AbdullahBarghouti/ece411/README.md

# ECE411

Practicum project for ECE 411

# Credits

Travis Hermant

Josh Davis

Abdullah Barghouti

Ammar Khan
