AbdullahBarghouti/ece411/Documents/ECE411 Decision Matrix - Sheet1.pdf

Project Ideas
| WT | Plant Monitor | Line Following Car | Light following solar panel | Pan and tilt camera mount
Cost | 4 | 3 | 2 | 1 | 4
Hardware Difficulty | 4 | 3 | 3 | 1 | 3
Software Difficulty | 3 | 2 | 3 | 3 | 4
Retail price | 2 | 2 | 1 | 2 | 4
Usability | 4 | 4 | 1 | 3 | 4
Time to make | 5 | 3 | 3 | 2 | 3
Score | | 65 | 50 | 43 | 79

Group 14
ECE411
