AbdullahBarghouti/ece411/EagleCAD/PCB Design/ECE411_Project1.png

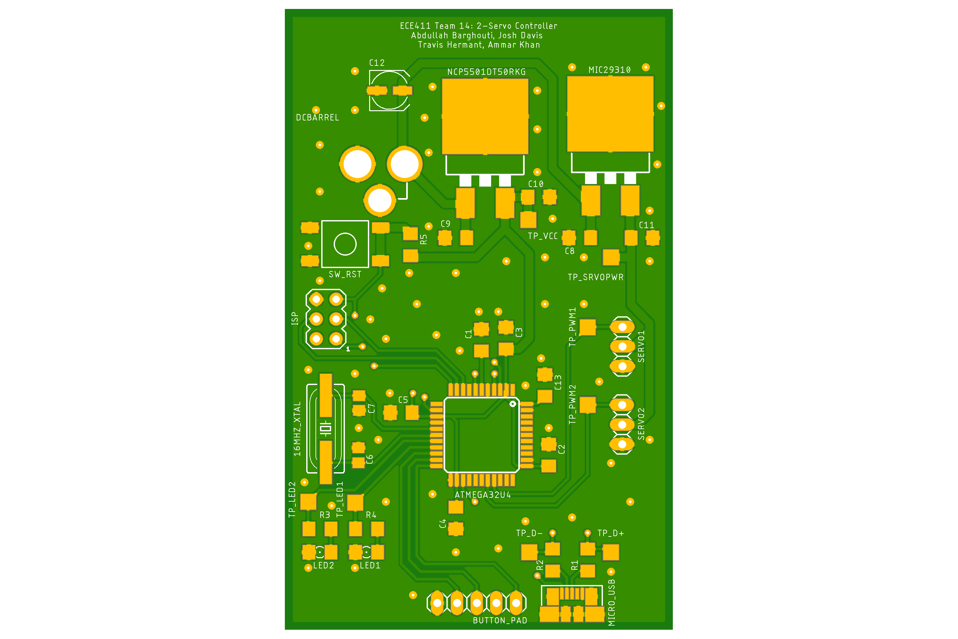
EagleCAD/PCB Design/ECE411_Project1.png
