AbdullahBarghouti/ece411/Documents/Arrow BOM ECE411 Practicum Project.xlsx

Arrow Electronics, Inc.
BOM Name: | ECE411 Practicum Project
Downloaded: | Thu Nov 15 2018 07:45:12 GMT+0000 (Coordinated Universal Time)
Part Details |  |  |  |  |  |  | Purchasing Options |  |  |  |  |  |  |  |  |  |  |  | Extra Part Details
Part Number | Manufacturer | Requested Qty | Quoted | Total Stock | Total Price | Description | Packaging | Allocated | Stock | Availability | Price per Part | Option Total | MOQ | Increment | Ships | Source | Location | Lead Time | Rohs | Lifecycle | Note | Details | Reference Designator(s)
CL31A106MOHNNNE | Samsung Electro-Mechanics | 10 | 10 | 12056 | 1.832 | Cap Ceramic 10uF 16V X5R 20% Pad SMD 1206 85°C T/R | Cut Strip | 10 | 12056 | In Stock | 0.2544 | 2.544 | 1 | 1 | Immediately | Arrow | USA | 30 Week(s) | Yes | Active |  | https://www.arrow.com/products/cl31a106mohnnne/samsung-electro-mechanics
C1206X105K5RECAUTO | KEMET Corporation | 6 | 6 | 764 | 3.135 | Cap Ceramic 1uF 50V X7R 10% Pad SMD 1206 Flexible Termination 125°C Automotive T/R | Cut Strip | 6 | 764 | In Stock | 0.5225 | 3.135 | 1 | 1 | Immediately | Arrow | USA | 47 Week(s) | Yes |  |  | https://www.arrow.com/products/c1206x105k5recauto/kemet-corporation
AC1206JR-071KL | Yageo | 10 | 10 | 1417 | 0.526 | Res Thick Film 1206 1K Ohm 5% 0.25W(1/4W) ±100ppm/°C Epoxy Pad SMD Automotive T/R | Cut Strip | 10 | 1417 | In Stock | 0.095 | 0.95 | 1 | 1 | Immediately | Arrow | USA | 7 Week(s) | No | Active |  | https://www.arrow.com/products/ac1206jr-071kl/yageo
CL31A475KOHNNNE | Samsung Electro-Mechanics | 6 | 6 | 20 | 1.995 | Cap Ceramic 4.7uF 16V X5R 10% Pad SMD 1206 85°C T/R | Cut Strip | 6 | 20 | In Stock | 0.3325 | 1.995 | 1 | 1 | Immediately | Arrow | USA | 30 Week(s) | Yes | Active |  | https://www.arrow.com/products/cl31a475kohnnne/samsung-electro-mechanics
47346-0001 | Molex | 5 | 5 | 14223 | 2.99 | Conn Micro USB 2.0 Type B RCP 5 POS 0.65mm Solder RA SMD 5 Terminal 1 Port T/R | Supplier | 5 | 14223 | In Stock | 0.598 | 2.99 | 5 | 1 | 11 Day(s) | Arrow | USA | 0 Week(s) | Yes | Active |  | https://www.arrow.com/products/47346-0001/molex
C1206C104K5JACTU | KEMET Corporation | 28 | 28 | 841 | 10.2116 | Cap Ceramic 0.1uF 50V U2J 10% Pad SMD 1206 125°C T/R | Cut Strip | 28 | 841 | In Stock | 0.437 | 12.236 | 1 | 1 | Immediately | Arrow | USA | 99 Week(s) | Yes |  |  | https://www.arrow.com/products/c1206c104k5jactu/kemet-corporation
NCP5501DT50RKG | ON Semiconductor | 5 | 5 | 3928 | 3.01 | LDO Regulator Pos 5V 0.5A 3-Pin(2+Tab) DPAK T/R | Cut Strip | 5 | 3928 | In Stock | 0.602 | 3.01 | 1 | 1 | Immediately | Arrow | USA | 9 Week(s) | No | Active |  | https://www.arrow.com/products/ncp5501dt50rkg/on-semiconductor
3642 | Adafruit Industries | 5 | 5 | 197 | 10.745 | Conn 2.1mm DC Barrel RCP Solder RA Thru-Hole 3 Terminal 1 Port | Supplier | 5 | 197 | In Stock | 2.149 | 10.745 | 1 | 1 | Immediately | Arrow | USA | 99 Week(s) | Yes | Active |  | https://www.arrow.com/products/3642/adafruit-industries
UWT1V100MCL1GB | Nichicon | 6 | 6 | 106014 | 1.653 | Cap Aluminum Lytic 10uF 35V 20% (5 X 5.4mm) SMD 25mA 1000h 105°C T/R | Supplier | 0 | 105000 | In Stock | 0 | 0 | 1000 | 1000 | 4 Day(s) | Arrow | NL | 20 Week(s) | Yes | Active |  | https://www.arrow.com/products/uwt1v100mcl1gb/nichicon
 |  |  |  |  |  |  | Reel | 0 | 1000 | In Stock | 0 | 0 | 1000 | 1000 | Immediately | Arrow | USA | 17 Week(s)
 |  |  |  |  |  |  | Cut Strip | 6 | 14 | In Stock | 0.2755 | 1.653 | 1 | 1 | Immediately | Arrow | USA | 17 Week(s)
QBLP650-AG | QT-Brightek Corporation | 12 | 12 | 8998 | 3.1584 | TOP MOUNT BRIGHT 1206 LEDS | Cut Strip | 12 | 8998 | In Stock | 0.36 | 4.32 | 1 | 1 | Immediately | Arrow | USA | 8 Week(s) | Yes | Active |  | https://www.arrow.com/products/qblp650-ag/qt-brightek-corporation
SG73G2BTTD1002D | KOA Speer Electronics | 6 | 6 | 4665 | 1.311 | Res Thick Film 1206 10K Ohm 0.5% 0.5W(1/2W) ±50ppm/°C Pad SMD Automotive T/R | Cut Strip | 6 | 4665 | In Stock | 0.2185 | 1.311 | 1 | 1 | Immediately | Arrow | USA | 10 Week(s) | No | Active |  | https://www.arrow.com/products/sg73g2bttd1002d/koa-speer-electronics
SG73G2BTTD22R0D | KOA Speer Electronics | 10 | 10 | 4971 | 2.163 | Res Thick Film 1206 22 Ohm 0.5% 0.5W(1/2W) ±50ppm/°C Pad SMD Automotive T/R | Cut Strip | 10 | 4971 | In Stock | 0.2185 | 2.185 | 1 | 1 | Immediately | Arrow | USA | 10 Week(s) | No | Active |  | https://www.arrow.com/products/sg73g2bttd22r0d/koa-speer-electronics
MIC29310-5.0WU | Microchip Technology | 5 | 5 | 798 | 10.905 | LDO Regulator Pos 5V 3A 4-Pin(3+Tab) TO-263 Tube | Supplier | 5 | 798 | In Stock | 2.181 | 10.905 | 1 | 1 | Immediately | Arrow | USA | 7 Week(s) | No | Active |  | https://www.arrow.com/products/mic29310-5.0wu/microchip-technology
ATS160SM-1 | CTS | 4 | 4 | 4 | 1.2712 | Crystal 16MHz ±30ppm (Tol) ±50ppm (Stability) Series FUND 40Ohm 2-Pin HC-49/US SM SMD T/R | Cut Strip | 4 | 4 | In Stock | 0.3178 | 1.2712 | 1 | 1 | Immediately | Arrow | USA | 9 Week(s) | Yes | Active |  | https://www.arrow.com/products/ats160sm-1/cts
08052A220JAT2A | AVX | 12 | 12 | 7750 | 2.166 | Cap Ceramic 22pF 200V C0G 5% Pad SMD 0805 125°C T/R | Cut Strip | 12 | 7750 | In Stock | 0.266 | 3.192 | 1 | 1 | Immediately | Arrow | USA | 30 Week(s) | Yes | Active |  | https://www.arrow.com/products/08052a220jat2a/avx
FSM2JSMLTR | TE Connectivity | 5 | 5 | 12000 | 2.8415 | Switch Tactile OFF (ON) SPST Round Button Gull Wing 0.05A 24VDC 0.98N SMD T/R | Reel | 0 | 10800 | In Stock | 0 | 0 | 1200 | 1200 | Immediately | Arrow | USA | 11 Week(s) | Yes | Active |  | https://www.arrow.com/products/fsm2jsmltr/te-connectivity
 |  |  |  |  |  |  | Cut Strip | 5 | 1200 | In Stock | 0.5683 | 2.8415 | 1 | 1 | Immediately | Arrow | USA | 11 Week(s)
150-1-002-0-S-XS0-0835 | MPE-Garry GmbH | 10 | 10 | 29 | 0.752 | Pin Header 2,00 mm Series 150 | Supplier | 10 | 29 | In Stock | 0.0846 | 0.846 | 1 | 1 | 4 Day(s) | Arrow | NL | 10 Week(s) | Yes | Active |  | https://www.arrow.com/products/150-1-002-0-s-xs0-0835/mpe-garry-gmbh
HPH2-A-06-UA | ADAM TECH | 6 | 6 | 100 | 3.81 | Pin Header 6P 1.27mm Pitch | Supplier | 6 | 100 | In Stock | 0.635 | 3.81 | 1 | 1 | Immediately | Arrow | USA | 0 Week(s) | Yes | Active |  | https://www.arrow.com/products/hph2-a-06-ua/adam-tech
