AbdullahBarghouti/ece411/Documents/ECE_411_Bill_of_Materials.xlsx

Table 1
Count | Part | Value | Device | Package | Description | SPICEPREFIX | Vendor | MFG | Cost Each ($) | Cost ext. ($) | Link
2 | BUTTON_PAD, SERVO1, SERVO2 |  | PINHD-1X10 | 1X10 | PIN HEADER |  | Arrow | MPE-Garry GmbH | 0.08 | 0.16 | https://www.arrow.com/en/products/150-1-002-0-s-xs0-0835/mpe-garry-gmbh
1 | C1 | 1u | C1206X105K5RECAUTO | C1206 | Ceramic Capacitor | C | Arrow | KEMET Corp | 0.52 | 0.52 | https://www.arrow.com/en/products/c1206x105k5recauto/kemet-corporation
6 | C2, C3, C4, C5, C8, C13 | 0.1u | C1206C104K5JACTU | C1206 | Ceramic Capacitor | C | Arrow | KEMET Corp | 0.44 | 2.64 | https://www.arrow.com/en/products/c1206c104k5jactu/kemet-corporation
2 | C6, C7 | 22p | 08052A220JAT2A | C0805 | Ceramic Capacitor | C | Arrow | AVX | 0.27 | 0.54 | https://www.arrow.com/en/products/08052a220jat2a/avx
2 | C9, C11 | 10u | CL31A106MOHNNNE | C1206 | Ceramic Capacitor | C | Arrow | Samsung Electro-Mechanics | 0.25 | 0.5 | https://www.arrow.com/en/products/cl31a106mohnnne/samsung-electro-mechanics
1 | C12 | 10u | UWT1V100MCL1GB | UD-5X5, 4_NICHICON | Dielectric (Polarized) Capacitor | C | Arrow | Nichicon | 0.04 | 0.04 | https://www.arrow.com/en/products/uwt1v100mcl1gb/nichicon
1 | C10 | 4.7u | CL31A475KOHNNNE | C1206 | Ceramic Capacitor | C | Arrow | Samsung Electro-Mechanics | 0.33 | 0.33 | https://www.arrow.com/en/products/cl31a475kohnnne/samsung-electro-mechanics
1 | ISP1 |  | AVRISP-6 | AVRISP | AVR ISP HEADER |  | Arrow | Adam Tech | 0.635 | 0.635 | https://www.arrow.com/en/products/hph2-a-06-ua/adam-tech
1 | MICRO_USB |  | 047346-0001 | MOLEX_USBMICRO | USB Micro Connector Type B |  | Arrow | Molex | 0.598 | 0.598 | https://www.arrow.com/en/products/47346-0001/molex
2 | LED1, LED2 |  | QBLP650-AG | 1206 | LED |  | Arrow | QT-Brightek | 0.36 | 0.72 | https://www.arrow.com/en/products/qblp650-ag/qt-brightek-corporation
2 | R1, R2 | 22 | SG73G2BTTD22R0D | R1206 | RESISTOR | R | Arrow | KOA Speer Electronics | 0.22 | 0.44 | https://www.arrow.com/en/products/sg73g2bttd22r0d/koa-speer-electronics
2 | R3, R4 | 1k | AC1206JR-071KL | R1206 | RESISTOR | R | Arrow | Yageo | 0.1 | 0.2 | https://www.arrow.com/en/products/ac1206jr-071kl/yageo
1 | R5 | 10k | SG73G2BTTD1002D | R1206 | RESISTOR | R | Arrow | KOA Speer Electronics | 0.22 | 0.22 | https://www.arrow.com/en/products/sg73g2bttd1002d/koa-speer-electronics
2 | SERVO1, SERVO2 |  | SG90 9G Nylon-Gear | SG90 | Servo Motor |  | Amazon |  | 1.8 | 3.6
1 | SW_RST |  | FSM2JSMLTR | FSM2JSMLTR | Push Button SPST Switch N.O. |  | Arrow | TE Connectivity | 0.57 | 0.57 | https://www.arrow.com/en/products/fsm2jsmltr/te-connectivity
1 | U$1 |  | ATMEGA32U4-AU | TQFP44 | Microcontroller |  | Arrow |  | 3.955 | 3.955
1 | XTAL1 | 16MHz | ATS160SM-1 | ATS160SM-1 | Crystal Oscillator |  | Arrow | CTS | 0.32 | 0.32 | https://www.arrow.com/en/products/ats160sm-1/cts
1 | U2 | MIC29310-5.0WU | MIC29310-5.0WU | TO-263/D2PAK | 5V 3A Linear Voltage Regulator |  | Arrow | Microchip | 2.18 | 2.18 | https://www.arrow.com/en/products/mic29310-5.0wu/microchip-technology
1 | U3 | NCP5501DT50RKG | NCP5501DT50RKG | TO-263/D2PAK | 5V 0.5A Linear Voltage Regulator |  | Arrow | ON Semiconductor | 0.6 | 0.6 | https://www.arrow.com/en/products/ncp5501dt50rkg/on-semiconductor
1 | U4 | DCJACK_2.1MM_PTH | 3462 | DCJACK_2.1MM_PTH | DC Barrel Jack (Thru-Hole) |  | Arrow | Adafruit | 2.15 | 2.15 | https://www.arrow.com/en/products/3642/adafruit-industries
 |  |  |  |  |  |  |  |  | Total $: | 20.92
