AbdullahBarghouti/ece411/EagleCAD/PCBSchematicImage.pdf

A

A

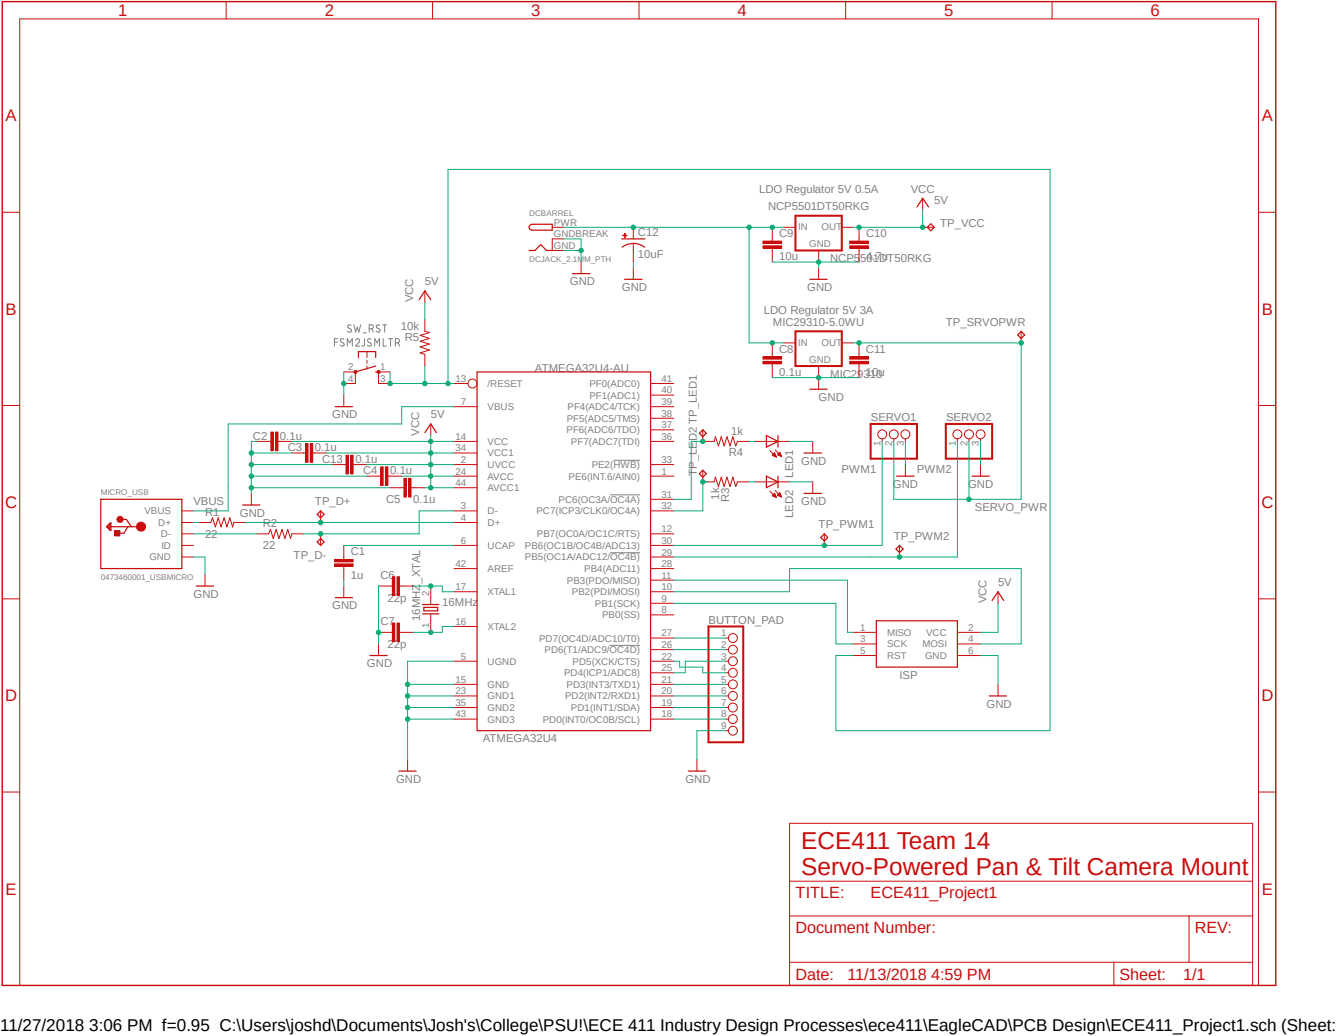
[picture p3: page 1]

0.1u
C13

ECE411 Team 14
Servo-Powered Pan & Tilt Camera Mount
TITLE:

Document Number: | REV:

Date: 11/13/2018 4:59 PM | Sheet: 1/1

11/27/2018 3:06 PM f=0.95 C:\Users\joshd\Documents\Josh's\College\PSU!\ECE 411 Industry Design Processes\ece411\EagleCAD\PCB Design\ECE411_Project1.sch (Sheet: 1/1)
