AbdullahBarghouti/ece411/EagleCAD/PCBLayoutImage.pdf

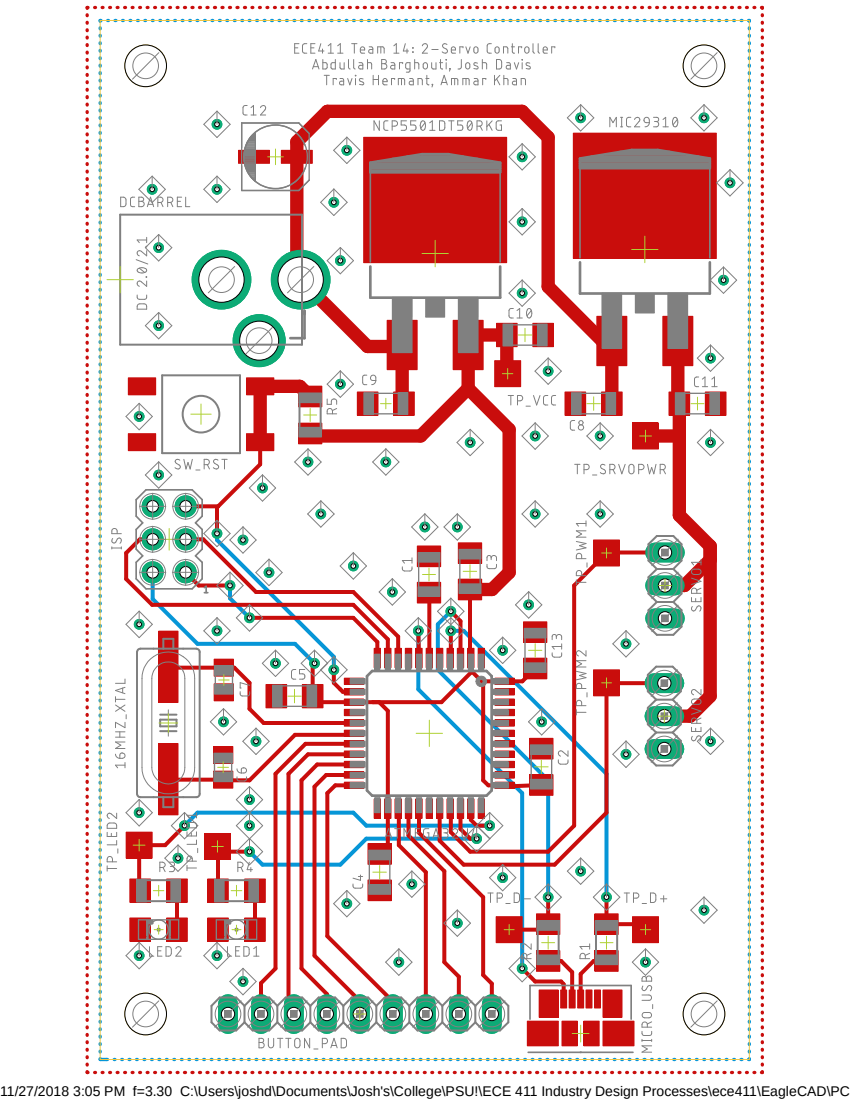
[picture p4: page 1]

11/27/2018 3:05 PM f=3.30 C:\Users\joshd\Documents\Josh's\College\PSU!\ECE 411 Industry Design Processes\ece411\EagleCAD\PCB Design\ECE411_Project1.brd
