AbdullahBarghouti/ece411/EagleCAD/PCB Design/ECE411_Project1.brd

## EAGLE design EagleCAD/PCB Design/ECE411_Project1.brd (2018-11-15)

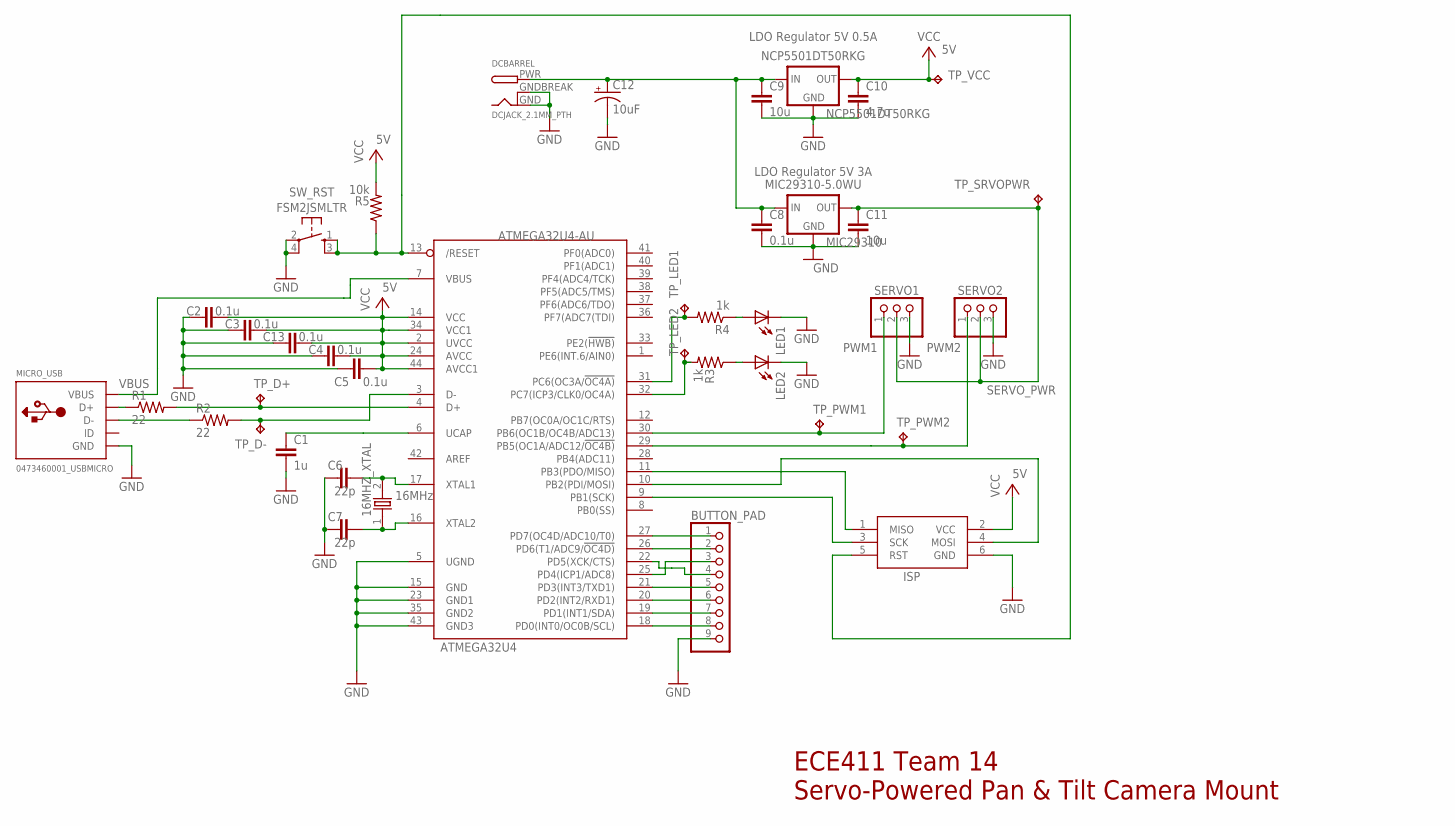
[picture p5: schematic ECE411_Project1.sch]

Parts:
16MHZ_XTAL: 16MHz; ATS160SM-1
ATMEGA32U4: ATMEGA32U4-AU; TQFP44
BUTTON_PAD: PINHD-1X9; 1X09
C1: 1u; C1206
C2, C3, C4, C5, C8, C13: 0.1u; C1206
C6, C7: 22p; C0805
C9, C11: 10u; C1206
C10: 4.7u; C1206
C12: 10uF; UD-5X5,4_NICHICON
DCBARREL: DCJACK_2.1MM_PTH
ISP: AVRISP-6; AVRISP
LED1, LED2: LEDSMT1206; 1206
MIC29310: MIC29310-5.0WU; TO-263/D2PAK
MICRO_USB: 0473460001_USBMICRO; MOLEX_USBMICRO
NCP5501DT50RKG: NCP5501DT50RKG; TO-263/D2PAK
R1, R2: 22; R1206
R3, R4: 1k; R1206
R5: 10k; R1206
SERVO1, SERVO2: PINHD-1X3; 1X03
SW_RST: FSM2JSMLTR
TP_D+: TPTP20SQ; TP20SQ
TP_D-: TPTP20SQ; TP20SQ
TP_LED1, TP_LED2: TPTP20SQ; TP20SQ
TP_PWM1, TP_PWM2: TPTP20SQ; TP20SQ
TP_SRVOPWR: TPTP20SQ; TP20SQ
TP_VCC: TPTP20SQ; TP20SQ

Connections:
/RST: ATMEGA32U4.13 (/RESET), ISP.5 (RST), R5.1, SW_RST.1, SW_RST.3
CHIP_LED1: ATMEGA32U4.31 (PC6(OC3A/!OC4A)), R4.2, TP_LED1.TP
CHIP_LED2: ATMEGA32U4.32 (PC7(ICP3/CLK0/OC4A)), R3.2, TP_LED2.TP
D+MCU: ATMEGA32U4.4 (D+), R1.2, TP_D+.TP
D+USB: MICRO_USB.3 (D+), R1.1
D-MCU: ATMEGA32U4.3 (D-), R2.2, TP_D-.TP
D-USB: MICRO_USB.2 (D-), R2.1
GND: ATMEGA32U4.5 (UGND), ATMEGA32U4.15 (GND), ATMEGA32U4.23 (GND1), ATMEGA32U4.35 (GND2), ATMEGA32U4.43 (GND3), BUTTON_PAD.9, C1.2, C2.1, C3.1, C4.1, C5.1, C6.1, C7.1, C8.2, C9.2, C10.2, C11.2, C12.-, C13.1, DCBARREL.GND, DCBARREL.GNDBREAK, ISP.6 (GND), LED1.C, LED2.C, MIC29310.2 (GND), MICRO_USB.5 (GND), MICRO_USB.G1 (GND), MICRO_USB.G2 (GND), MICRO_USB.G3 (GND), MICRO_USB.G4 (GND), MICRO_USB.G5 (GND), MICRO_USB.G6 (GND), NCP5501DT50RKG.2 (GND), SERVO1.3, SERVO2.3, SW_RST.2, SW_RST.4
unnamed: ATMEGA32U4.27 (PD7(OC4D/ADC10/T0)), BUTTON_PAD.1
unnamed: ATMEGA32U4.26 (PD6(T1/ADC9/!OC4D)), BUTTON_PAD.2
unnamed: ATMEGA32U4.25 (PD4(ICP1/ADC8)), BUTTON_PAD.3
unnamed: ATMEGA32U4.22 (PD5(XCK/CTS)), BUTTON_PAD.4
unnamed: ATMEGA32U4.21 (PD3(INT3/TXD1)), BUTTON_PAD.5
unnamed: ATMEGA32U4.20 (PD2(INT2/RXD1)), BUTTON_PAD.6
unnamed: LED2.A, R3.1
unnamed: LED1.A, R4.1
unnamed: ATMEGA32U4.19 (PD1(INT1/SDA)), BUTTON_PAD.7
unnamed: ATMEGA32U4.18 (PD0(INT0/OC0B/SCL)), BUTTON_PAD.8
unnamed: ATMEGA32U4.11 (PB3(PDO/MISO)), ISP.1 (MISO)
unnamed: ATMEGA32U4.10 (PB2(PDI/MOSI)), ISP.4 (MOSI)
unnamed: ATMEGA32U4.9 (PB1(SCK)), ISP.3 (SCK)
PWM1: ATMEGA32U4.30 (PB6(OC1B/OC4B/ADC13)), SERVO1.1, TP_PWM1.TP
PWM2: ATMEGA32U4.29 (PB5(OC1A/ADC12/!OC4B)), SERVO2.1, TP_PWM2.TP
SERVO_PWR: C11.1, MIC29310.3 (OUT), SERVO1.2, SERVO2.2, TP_SRVOPWR.TP
UCAP: ATMEGA32U4.6 (UCAP), C1.1
UNREG_PWR: C8.1, C9.1, C12.+, DCBARREL.PWR, MIC29310.1 (IN), NCP5501DT50RKG.1 (IN)
VBUS: ATMEGA32U4.7 (VBUS), MICRO_USB.1 (VBUS)
VCC: ATMEGA32U4.2 (UVCC), ATMEGA32U4.14 (VCC), ATMEGA32U4.24 (AVCC), ATMEGA32U4.34 (VCC1), ATMEGA32U4.44 (AVCC1), C2.2, C3.2, C4.2, C5.2, C10.1, C13.2, ISP.2 (VCC), NCP5501DT50RKG.3 (OUT), R5.2, TP_VCC.TP
XTAL1: 16MHZ_XTAL.2, ATMEGA32U4.17 (XTAL1), C6.2
XTAL2: 16MHZ_XTAL.1, ATMEGA32U4.16 (XTAL2), C7.2

Notes on the sheet:
LDO Regulator 5V 0.5A
LDO Regulator 5V 3A
ECE411 Team 14 Servo-Powered Pan & Tilt Camera Mount

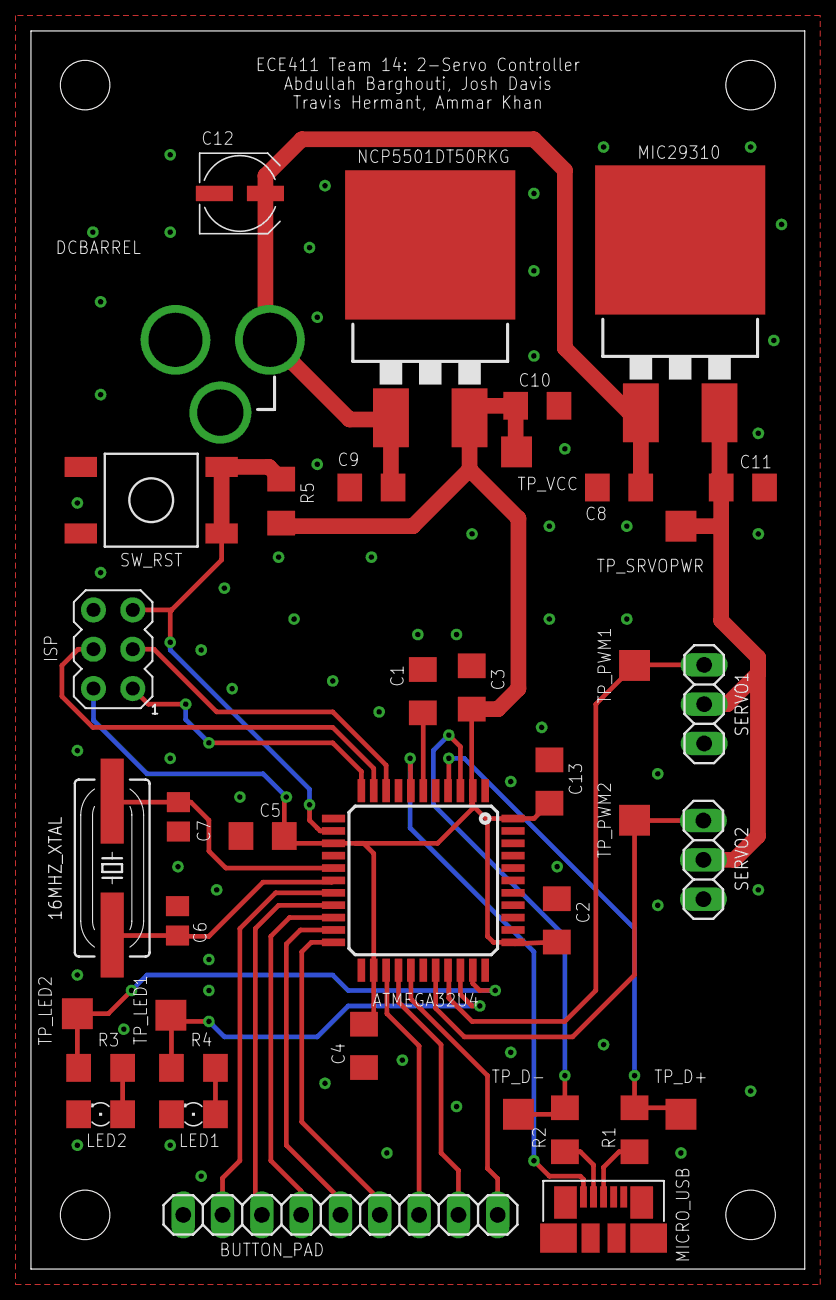
[picture p6: board ECE411_Project1.brd from above]

Board: 2 copper layers, 50.0 x 80.0 mm, 39 parts (0 on the bottom side), 30 nets.
