AbdullahBarghouti/ece411/EagleCAD/Adafruit-ItsyBitsy-32u4-PCB-master/Itsy Bitsy 32u4 5V.brd

## EAGLE design EagleCAD/Adafruit-ItsyBitsy-32u4-PCB-master/Itsy Bitsy 32u4 5V.brd (2018-10-24)

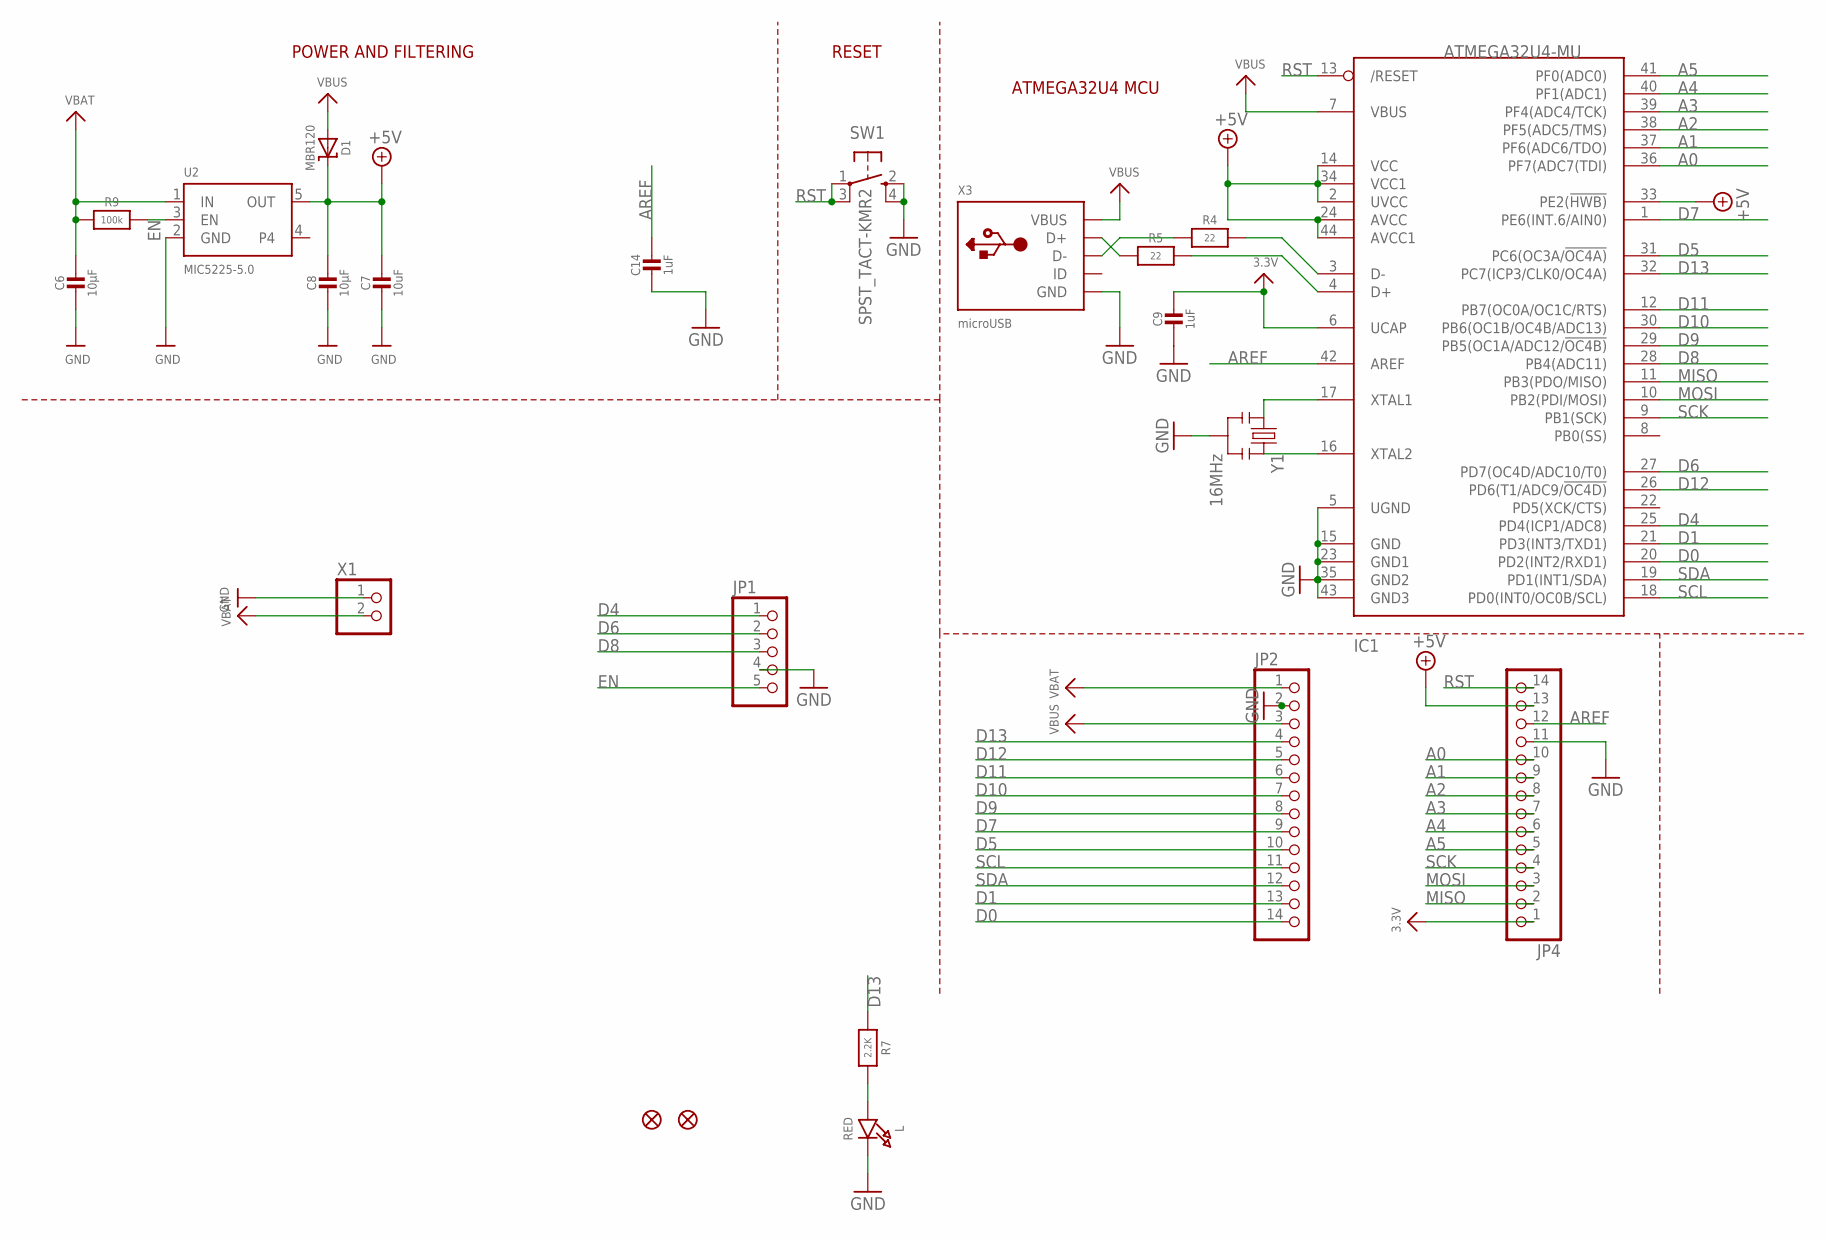
[picture p7: schematic Itsy Bitsy 32u4 5V.sch]

Parts:
C6, C8: 10µF; 0805-NO
C7: 10uF; 0805-NO
C9, C14: 1uF; 0603-NO
D1: MBR120; SOD-123
IC1: ATMEGA32U4-MU; TQFN44_7MM
JP1: HEADER-1X5ROUND; 1X05_ROUND
JP2, JP4: HEADER-1X14; 1X14_ROUND70
L: RED; CHIPLED_0805_NOOUTLINE
R4, R5: 22; 0603-NO
R7: 2.2K; 0603-NO
R9: 100k; 0603-NO
SW1: SPST_TACT-KMR2; KMR2
U2: MIC5225-5.0; SOT23-5
U$34, U$35: FIDUCIAL""; FIDUCIAL_1MM
X1: CON_JST_PH_2PIN; JSTPH2
X3: microUSB; 4UCONN_20329_V2
Y1: 16MHz; RESONATOR-SMD

Connections:
3.3V: C9.1, IC1.6 (UCAP), JP4.1
+5V: C7.1, C8.1, D1.C, IC1.2 (UVCC), IC1.14 (VCC), IC1.24 (AVCC), IC1.33 (PE2(!HWB)), IC1.34 (VCC1), IC1.44 (AVCC1), JP4.13, U2.5 (OUT)
A0: IC1.36 (PF7(ADC7(TDI)), JP4.10
A1: IC1.37 (PF6(ADC6/TDO)), JP4.9
A2: IC1.38 (PF5(ADC5/TMS)), JP4.8
A3: IC1.39 (PF4(ADC4/TCK)), JP4.7
A4: IC1.40 (PF1(ADC1)), JP4.6
A5: IC1.41 (PF0(ADC0)), JP4.5
AREF: C14.1, IC1.42 (AREF), JP4.12
D0: IC1.20 (PD2(INT2/RXD1)), JP2.14
D1: IC1.21 (PD3(INT3/TXD1)), JP2.13
D4: IC1.25 (PD4(ICP1/ADC8)), JP1.1
D5: IC1.31 (PC6(OC3A/!OC4A)), JP2.10
D6: IC1.27 (PD7(OC4D/ADC10/T0)), JP1.2
D7: IC1.1 (PE6(INT.6/AIN0)), JP2.9
D8: IC1.28 (PB4(ADC11)), JP1.3
D9: IC1.29 (PB5(OC1A/ADC12/!OC4B)), JP2.8
D10: IC1.30 (PB6(OC1B/OC4B/ADC13)), JP2.7
D11: IC1.12 (PB7(OC0A/OC1C/RTS)), JP2.6
D12: IC1.26 (PD6(T1/ADC9/!OC4D)), JP2.5
D13: IC1.32 (PC7(ICP3/CLK0/OC4A)), JP2.4, R7.1
D+: IC1.4 (D+), R5.2
D-: IC1.3 (D-), R4.2
EN: JP1.5, R9.2, U2.3 (EN)
GND: C6.2, C7.2, C8.2, C9.2, C14.2, IC1.5 (UGND), IC1.15 (GND), IC1.23 (GND1), IC1.35 (GND2), IC1.43 (GND3), JP1.4, JP2.2, JP4.11, L.C, SW1.2 (S), SW1.4 (S1), U2.2 (GND), X1.1, X3.BASE@1 (GND), X3.BASE@2 (GND), X3.GND, X3.SPRT@1 (GND), X3.SPRT@2 (GND), X3.SPRT@3 (GND), X3.SPRT@4 (GND), Y1.2
MISO: IC1.11 (PB3(PDO/MISO)), JP4.2
MOSI: IC1.10 (PB2(PDI/MOSI)), JP4.3
unnamed: L.A, R7.2
unnamed: IC1.16 (XTAL2), Y1.3
unnamed: IC1.17 (XTAL1), Y1.1
unnamed: R5.1, X3.D+
unnamed: R4.1, X3.D-
RST: IC1.13 (/RESET), JP4.14, SW1.1, SW1.3 (P1)
SCK: IC1.9 (PB1(SCK)), JP4.4
SCL: IC1.18 (PD0(INT0/OC0B/SCL)), JP2.11
SDA: IC1.19 (PD1(INT1/SDA)), JP2.12
VBAT: C6.1, JP2.1, R9.1, U2.1 (IN), X1.2
VBUS: D1.A, IC1.7 (VBUS), JP2.3, X3.VBUS

Notes on the sheet:
POWER AND FILTERING
RESET
ATMEGA32U4 MCU

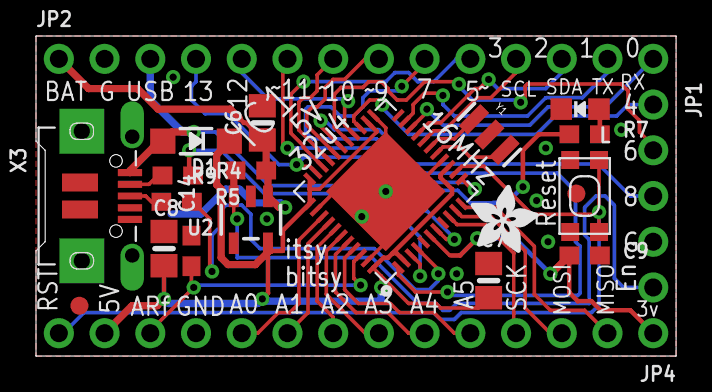
[picture p8: board Itsy Bitsy 32u4 5V.brd from above]

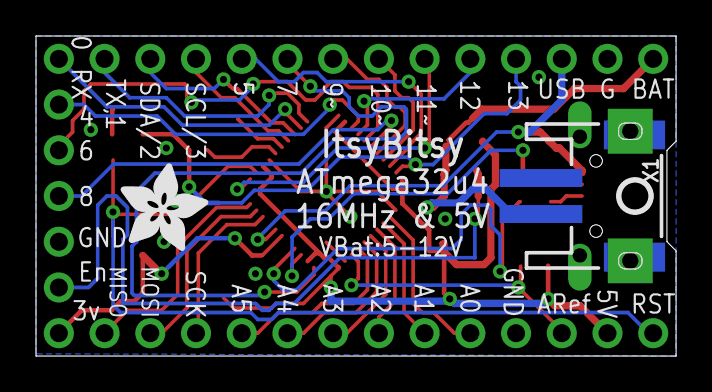
[picture p9: board Itsy Bitsy 32u4 5V.brd from below]

Board: 2 copper layers, 35.6 x 17.8 mm, 25 parts (3 on the bottom side), 38 nets.

Other parts of the board:
U$4: ADAFRUIT_5MM
U$7: ADAFRUIT_3.5MM
U$10: PCBFEAT-REV-040
