AbdullahBarghouti/ece411/(commit log)

2018-10-24 Added Itsy Bitsy EagleCad schematic to the repo
    [Itsy Bitsy 32u4 3V.brd, Itsy Bitsy 32u4 3V.sch, Itsy Bitsy 32u4 5V.brd, Itsy Bitsy 32u4 5V.sch, PCB_Schematic_V1.sch]
2018-10-25 Add files via upload
    Preliminary schematic
    [ECE411_Project1.sch, Project1.sch]
2018-10-25 Create Preliminary schematic
2018-10-25 Added push button for ~Reset pin; named USB port
2018-10-25 removed empty schematic1 EagleCAD file
    [PCB_Schematic_V1.sch]
2018-10-25 Beautified the circuit: rotated and connected the servos directly to the ATMega32U4
    [ECE411_Project1.sch]
2018-10-26 Added ISP 6-pin port to the schematic
    [ECE411_Project1.sch]
2018-11-01 In-Progress schematic: working to add voltage regulators
    [ECE411_Project1.brd, ECE411_Project1.sch]
2018-11-02 Cleaning up
    [ECE411_Project1.brd, ECE411_Project1.sch]
2018-11-03 Added Custom libraries - one for the NE5532 example from the workshop and one for the L7805ABV voltage regulator from the EPL.
2018-11-03 Made Xtal library file
    [ECE411_Project1.brd, ECE411_Project1.sch]
2018-11-03 updates to schematic
    [ECE411_Project1.sch]
2018-11-03 Updating schematic... Updated Links document.
2018-11-04 Added some custom library components, updated schematic with new xtal cap values, and updated links document
    [ECE411_Project1.brd, ECE411_Project1.sch]
2018-11-04 Updating schematic,added push button library file
2018-11-04 Updated Schematic
    [ECE411_Project1.brd, ECE411_Project1.sch]
2018-11-04 Visually complete schematic - nets need to be named still, and erc needs to be run.
    [ECE411_Project1.brd, ECE411_Project1.sch]
2018-11-04 changed xtal caps to 0805 size from 1206
    [ECE411_Project1.brd, ECE411_Project1.sch]
2018-11-04 Updated schematic with new DC barrel component that is thru-hole 2.1MM size
    [ECE411_Project1.brd, ECE411_Project1.sch]
2018-11-04 Started the PCB - Everything's on the board and messy!
    [ECE411_Project1.brd, ECE411_Project1.sch]
2018-11-04 Added test points all over the place
    [ECE411_Project1.brd, ECE411_Project1.sch]
2018-11-05 Add files via upload
    connections made and test passed
    [ECE411_Project1.brd]
2018-11-06 Updated schem and brd files
    [ECE411_Project1_RE.brd, ECE411_Project1_RE.sch]
2018-11-06 Fixed a couple ERC errors... there are a couple left still.
    [ECE411_Project1_RE.sch]
2018-11-07 added electrolytic cap to schematic
2018-11-08 added design review for Team 7
    [BOM file FROM TAI.xlsx, BOM file.xlsx, freq_count_schematic_110718.sch, freq_count_schematic_updated_11_6_2018.brd]
2018-11-08 Restarted the PCB layout process, and created new schematic and layout files to use. The new file names removed the _RE at the end, they're titled ECE411_Project1
    [ECE411_Project1.brd, ECE411_Project1.sch]
2018-11-08 updated in-progress PCB layout
2018-11-08 in-progress updates: Connected Vbuses in schematic, organized the new layout design
    [ECE411_Project1.brd]
2018-11-08 In-progress updates: Connected UVCC to power and added a capacitor for it
    [ECE411_Project1.brd, ECE411_Project1.sch]
2018-11-08 In-Progress Updates: Still fitting out the layout board file
    [ECE411_Project1.brd]
2018-11-09 In progress - almost finished layout
    [ECE411_Project1.brd]
2018-11-09 Add files via upload
    Here is the completed Bill of Materials.
    [Bill of Materials ECE 411.xlsx]
2018-11-09 Updated the Bill of Materials
    Added the material numbers along with the package number
    [ECE 411 Bill of Materials Updated.xlsx]
2018-11-09 Bill of Materials Updated
    This BOM has the package numbers along with the device numbers
    [ECE 411 Bill of Materials.xlsx]
2018-11-09 rearranged old eagle files into subfolder
    [ECE411_Project1_RE.brd, ECE411_Project1_RE.sch]
2018-11-09 This is the old one
    [Bill of Materials ECE 411.xlsx]
2018-11-09 This is also the old one
    [ECE 411 Bill of Materials Updated.xlsx]
2018-11-09 Adding BOM
    [ECE_411_Bill_of_Materials.xlsx]
2018-11-09 updated BOM, completed Layout. Still need to add team number and project description to schematic
    [ECE411_Project1.brd, ECE411_Project1.sch, ECE_411_Bill_of_Materials.xlsx]
2018-11-09 added name and project description to schematic
    [ECE411_Project1.sch]
2018-11-09 Added team number and project device description, and fixed what layer it goes in.
    [ECE411_Project1.sch]
2018-11-10 Updated the Board Layout: Added stitching vias, double gnd planes, set isolate distance to 10mils, smashed all the components and made their tnames look cohesive.
    [ECE411_Project1.brd, ECE411_Project1.sch]
2018-11-12 Updated board layout: moved power trace over so it wouldn't potentially bridge with the adjacent 32U4 pin; also moved button pad headers away from USB
    [ECE411_Project1.brd]
2018-11-13 updated the BOM excel
    [ECE_411_Bill_of_Materials.xlsx]
2018-11-13 Updated BOM
    [ECE_411_Bill_of_Materials.xlsx]
2018-11-14 Changed the schematic: moved the LEDs, and outputted the whole D port to a 9-pin header, with the ninth pin going to ground for the button pad.
    [ECE411_Project1.brd, ECE411_Project1.sch]
2018-11-14 Updated the schematic and the layout to output port D.
    [ECE411_Project1.brd, ECE411_Project1.sch]
2018-11-14 Added Arrow BOM excel file, and updated our BOM excel file to include the two headers we'll order
    [Arrow BOM ECE411 Practicum Project.xlsx, ECE_411_Bill_of_Materials.xlsx]
2018-11-15 Added 3.2mm drill holes to the four corners of the layout
    [ECE411_Project1.brd, ECE_411_Bill_of_Materials.xlsx]
2018-11-16 Fixed pins for arduino configuration
    [Camera_Controller.ino]
2018-11-16 Updated Arrow BOM which has been ordered.
    [Arrow BOM ECE411 Practicum Project.xlsx]
2018-12-02 Travis's preliminary updates to the Arduino Code.
2018-12-04 Travis's next gen code resolving the issue of getting stuck on full rotation. Still need to resolve the collision issue between servos.
    [Camera_Controller.ino]
